HumbaAdob0/3in1bot/README.md

# Hybrid 3-in-1 Bot

## Overview

<p align="center">
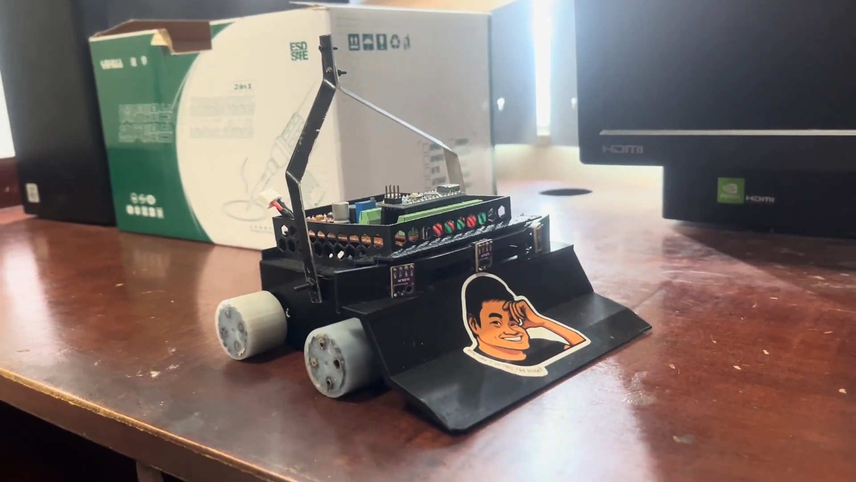
[picture p1: Photos/bot_image.png]
Completed Hybrid 3-in-1 Competition Bot
  
</p>

The Hybrid 3-in-1 Competition Bot is a four-wheel Arduino robotics platform designed for three challenges without rebuilding the electronics: **sumo**, **line following**, and **balloon hunt / pop**. It uses three VL53L0X time-of-flight (ToF) sensors to locate targets, a QTR-8D array to follow lines and detect arena boundaries, and independent left/right motor control for fast turns and recovery.

The competition front is the wedge / sensor side. In balloon mode, the bot uses a fixed front needle to pop a balloon after the center ToF sensor brings it into range.

| Controller | Drive | Modes | Power |
| --- | --- | --- | --- |
| Arduino Nano (ATmega328P) | Left/right differential drive with TB6612FNG drivers | Standby, Sumo, Line Follower, Balloon Hunt | 7.4 V LiPo + regulated 5 V rail |

## Features

- **Sumo mode** — scans with three ToF sensors, steers toward an opponent, and reverses/turns away from the light arena boundary.
- **Line-follower mode** — six active QTR sensors feed an adaptive PD controller with curve slowing, apex braking, and lost-line recovery.
- **Balloon-hunt mode** — locates a balloon with the ToF array, protects the arena boundary, then drives the fixed front needle into the target.
- **Safe mode selection** — a two-switch DIP state machine includes immediate standby and a 5-second default start delay for active modes.
- **Field-tunable firmware** — motor direction, sensor polarity, target distances, speeds, and recovery timing are grouped near the top of [`hybrid_bot.ino`](hybrid_bot.ino).

## CAD model

<p align="center">
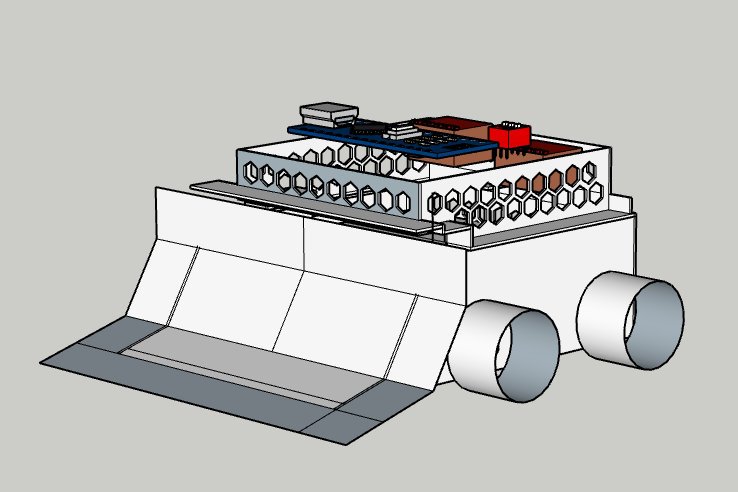
[picture p2: Photos/sketchup_front_view.png]
SketchUp front view of the robot
  
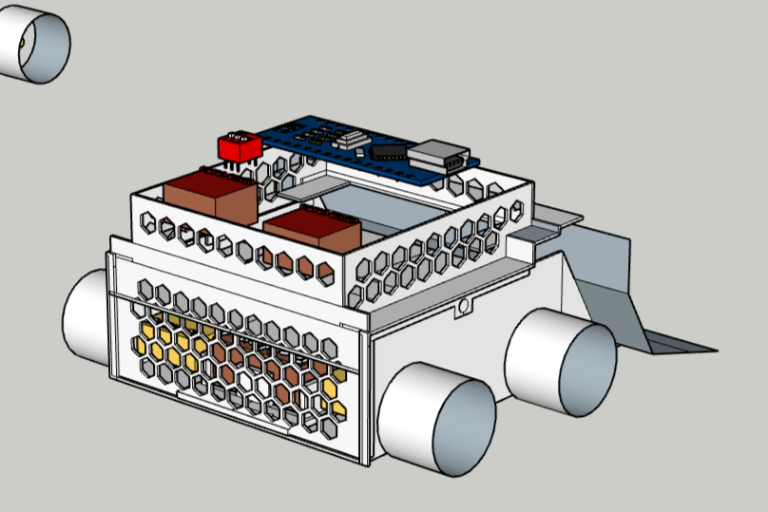
[picture p3: Photos/sketchup_back_view.png]
SketchUp rear view of the robot
  
</p>

The interactive model is available in [SketchUp](https://app.sketchup.com/share/tc/asia/sV_tgGeKpns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). It is a useful starting point for remaking or adapting the chassis, wedge, sensor mounts, and electronics enclosure.

## Build of materials

| Qty. | Part | Role / notes |
| ---: | --- | --- |
| 1 | Arduino Nano (ATmega328P) | Main controller; firmware serial output is 115200 baud. |
| 2 | TB6612FNG dual motor-driver boards | H-bridge motor control. The firmware exposes one PWM/direction group for each side of the drivetrain. |
| 4 | 600 DC gearmotor chassis | Differential drive; the CAD model shows two wheels on each side. |
| 3 | VL53L0X ToF distance sensors | Left, center, and right target detection. The side sensors are mounted about 20° outward. |
| 1 | QTR-8D reflectance / line-sensor array | Line tracking and boundary detection. Six outputs are active in the supplied firmware. |
| 1 | 3-position DIP-switch module | Two positions select the software mode; the third position is available for the power arrangement shown in the schematic. |
| 1 | 7.4 V LiPo battery | Motor supply input. Use a battery appropriate for the motors' current draw. |
| 1 | Step-down (buck) converter | Produces the regulated 5 V logic rail. |
| 1 | Front wedge / plow | Sumo attachment and competition-front reference. |
| 1 | Fixed front needle | Passive balloon popper; install and handle only under appropriate competition safety rules. |
| As needed | Wire, connectors, standoffs, fasteners, chassis material | Use secure, strain-relieved wiring—robot vibration is significant. |

## Wiring and pin map

<p align="center">
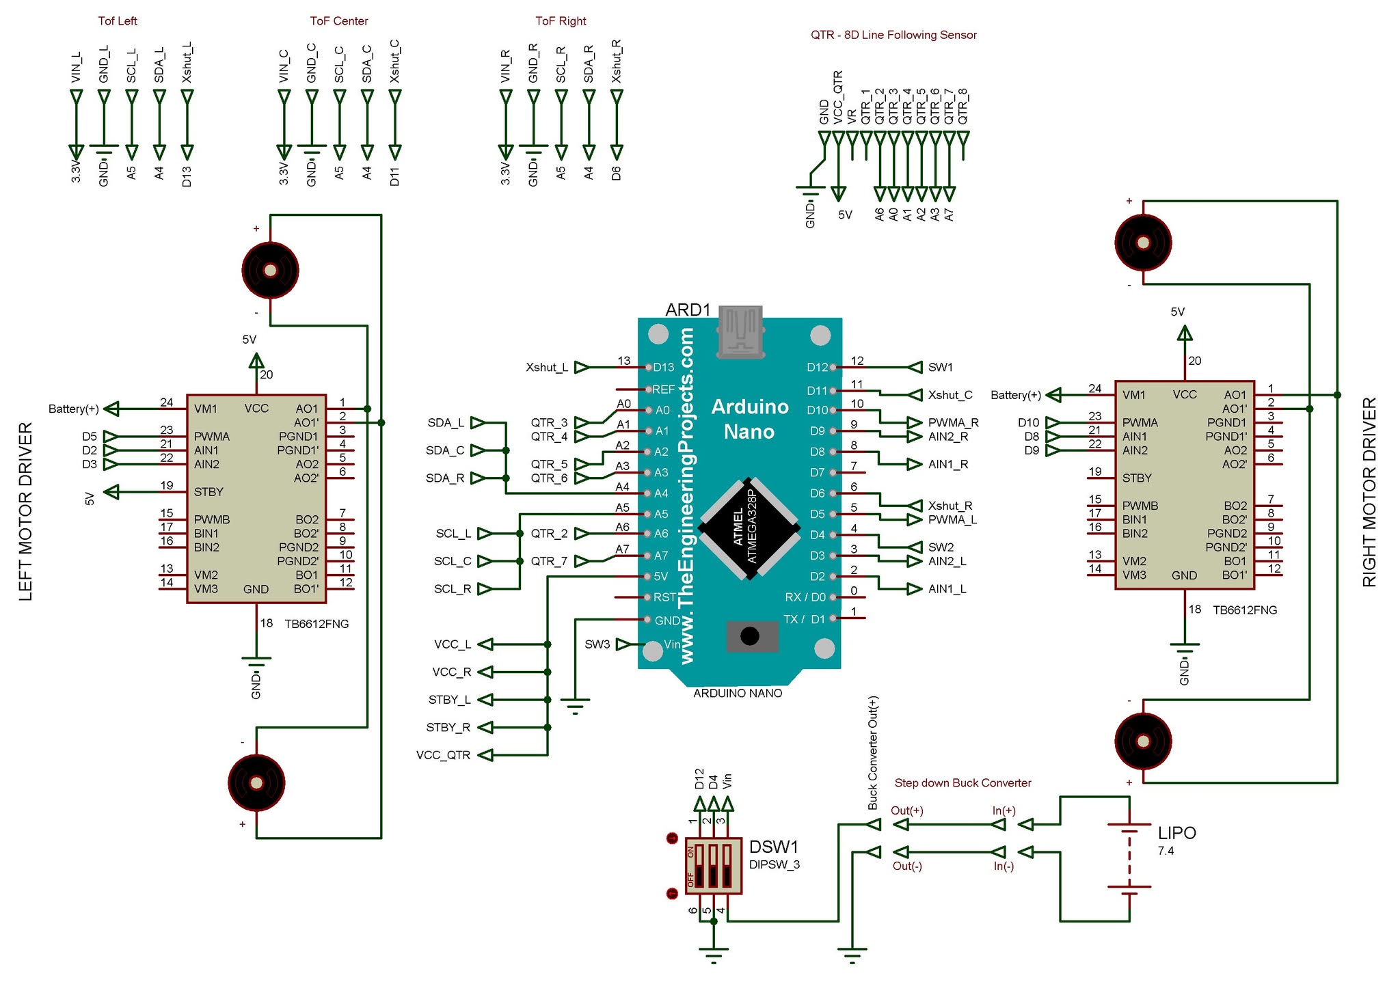
[picture p4: Photos/proteus_pin_map.jpg]
Proteus wiring and Arduino Nano pin map
  <br>
  <sub>Click the diagram to view it at full resolution.</sub>
</p>

The diagram above is the hardware reference. The pin definitions in [`hybrid_bot.ino`](hybrid_bot.ino) are the **source of truth for the current firmware**—especially for the QTR array, where this robot deliberately uses six working channels.

### Power architecture

```text
7.4 V LiPo
  ├──> TB6612FNG VM (motor supply)
  └──> buck converter ──> regulated 5 V logic rail
                              ├──> Arduino Nano 5V
                              ├──> TB6612FNG VCC and STBY
                              └──> QTR-8D VCC

Arduino 3.3 V ──> VL53L0X VIN
All modules ─────> common GND
```

Keep the motor supply, logic supply, and all grounds wired as shown. Do **not** connect the 7.4 V battery directly to a 5 V or 3.3 V sensor rail. Confirm the buck converter output with a multimeter before connecting the Nano or sensors.

### Motor drivers

| Side  | TB6612FNG input | Arduino Nano pin | Purpose |
| ----- | --- | --- | --- |
| Left  | AIN1 | D2 | Direction 1 |
| Left  | AIN2 | D3 | Direction 2 |
| Left  | PWMA | D5 | PWM speed control |
| Right | AIN1 | D8 | Direction 1 |
| Right | AIN2 | D9 | Direction 2 |
| Right | PWMA | D10 | PWM speed control |
| Both  | STBY | 5 V | Keep the drivers enabled |
| Both  | VCC / GND | 5 V / common GND | Logic power |
| Both  | VM | Battery positive | Motor power |

Connect each driver output to its corresponding drivetrain side as shown in the Proteus diagram. If a wheel turns in the wrong direction, change `LEFT_MOTOR_SIGN` or `RIGHT_MOTOR_SIGN` in the firmware before changing the mode logic.

### VL53L0X ToF sensors

All three sensors share the I²C bus. Separate XSHUT lines let the firmware start and re-address them one at a time.

| Sensor | SDA | SCL | XSHUT | I²C address after startup |
| --- | --- | --- | ----- | --- |
| Left | A4  | A5  | D13 | `0x30` |
| Center | A4  | A5  | D11 | `0x31` |
| Right  | A4  | A5  | D6 | `0x32` |

Wire each module's `VIN` to the Nano 3.3 V pin and each `GND` to common ground. The code configures the left and right sensors at roughly 20° outward for a wider detection field.

### QTR-8D line / boundary array

The current sketch uses six channels. `OUT4` is omitted because that physical sensor is defective, and `OUT6` is omitted because the A2 connection read stuck HIGH during testing.

| QTR-8D output, left to right | Arduino Nano pin | Firmware status |
| --- | --- | --- |
| OUT0 | D7 | Used |
| OUT1 | A6 | Used |
| OUT2 | A0 | Used |
| OUT3 | A1 | Used |
| OUT4 | — | Not used — defective sensor |
| OUT5 | A3 | Used |
| OUT6 | — | Not used — A2 reading stuck HIGH |
| OUT7 | A7 | Used |
| VCC / GND | 5 V / common GND | Required |

`A6` and `A7` are analog-input-only Nano pins, so the sketch reads them with `analogRead()` and converts their digital-style signal using the configured threshold. This is intentional.

### DIP-switch mode selector

The firmware uses the Nano's internal pull-ups. An **ON** switch must connect its pin to **GND** (`LOW`).

| SW2 (D4) | SW1 (D12) | Selected mode | What it does |
| --- | --- | --- | --- |
| OFF | OFF | Standby | Stops the motors immediately. |
| OFF | ON | Sumo | Searches for and pushes an opponent while avoiding the ring edge. |
| ON | OFF | Line Follower | Follows a dark line with adaptive PD steering. |
| ON | ON | Balloon Hunt / Pop | Finds a balloon, avoids the boundary, and rams the fixed popper.  |

Changing into an active mode is debounced and then waits 5 seconds by default (`START_DELAY_MS`). Set it to `0` only when that delay is not wanted.

## Getting started

### 1. Build the mechanics

1. Use the [SketchUp model](https://app.sketchup.com/share/tc/asia/sV_tgGeKpns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) and the included renders as a chassis reference.
2. Mount the motors and wedge securely. Place the ToF sensors across the competition front: left, center, then right.
3. Position the QTR array low and square to the floor. Its readings must be stable on both the track and the arena boundary.
4. Fit the fixed needle only when the robot is being used in a controlled balloon-popping event.

### 2. Wire and inspect

1. Follow the pin tables above and [full Proteus diagram](Photos/proteus_pin_map.jpg).
2. Ensure every module shares ground.
3. Verify the 5 V buck output and the 3.3 V ToF supply before attaching electronics.
4. With the wheels raised, test motor directions before putting the robot on a track or sumo ring.

### 3. Upload the firmware

1. Install the Arduino IDE.
2. In Library Manager, install **VL53L0X by Pololu**. `Wire` is included with the Arduino core.
3. Open [`hybrid_bot.ino`](hybrid_bot.ino), select the correct **Arduino Nano** board, processor/bootloader variant, and serial port, then upload.
4. Open Serial Monitor at **115200 baud**. Startup diagnostics report ToF initialization and QTR readings.
5. Leave both DIP switches OFF for standby, then select a mode from the table above.

### 4. Calibrate for your build

No two handmade robots have exactly the same motor direction, floor reflectance, battery voltage, or sensor height. Review the `CONFIG` section before every new arena or track:

| Check | Firmware settings to review |
| --- | --- |
| Drive direction | `LEFT_MOTOR_SIGN`, `RIGHT_MOTOR_SIGN`, `SUMO_FORWARD_SIGN` |
| ToF detection range and response  | `SUMO_*`, `BALLOON_*`, `TOF_ANGLE_DEGREES` |
| QTR polarity / boundary detection | `QTR_DARK_IS_HIGH`, `SUMO_EDGE_IS_DARK`, `BALLOON_BOUNDARY_IS_DARK` |
| Line speed and steering | `LINE_BASE_PWM`, `LINE_MAX_PWM`, `LINE_KP_DIV`, `LINE_KD_DIV` |
| Competition delay and diagnostics | `START_DELAY_MS`, `DEBUG_SERIAL` |

The supplied configuration expects a dark/black sumo platform or line response and a lighter area beyond the boundary. Use the Serial Monitor to confirm actual QTR values before changing polarity flags.

## Firmware behavior

```text
DIP mode
  ├── Standby       → motors stopped
  ├── Sumo          → QTR boundary check → ToF target/chase/search
  ├── Line Follower → QTR weighted position → PD steering/recovery
  └── Balloon Hunt  → QTR boundary check → ToF target/chase → fixed-needle ram
```

In both sumo and balloon modes, boundary escape has priority over target pursuit: the robot reverses, turns inward, and only then resumes the search. The line follower automatically slows for tight curves and pivots toward the last known line direction if the line disappears.

By default, balloon popping is passive (`USE_ELECTRIC_POPPER 0`). The code has a provision for an optional electronic popper, but no actuator should be connected directly to an Arduino pin; use a suitable MOSFET, servo driver, or other driver stage.

## Repository layout

| Path | Description |
| --- | --- |
| [`hybrid_bot.ino`](hybrid_bot.ino) | Arduino firmware for all four operating modes. |
| [`Photos/bot_image.png`](Photos/bot_image.png) | Photograph of the completed robot. |
| [`Photos/sketchup_front_view.png`](Photos/sketchup_front_view.png) | Front CAD render. |
| [`Photos/sketchup_back_view.png`](Photos/sketchup_back_view.png) | Rear CAD render. |
| [`Photos/proteus_pin_map.jpg`](Photos/proteus_pin_map.jpg) | Wiring and Arduino Nano pin-map reference. |
| [`LineFollower-Track-ModelV2.pdf`](LineFollower-Track-ModelV2.pdf) | Line-follower course reference. |

## Contributing and open source

This project is intended to be a practical, remixable starting point for student and competition robotics. Contributions are especially useful when they improve reproducibility:

- Document tested substitutions for motors, drivers, batteries, sensors, or chassis materials.
- Include measured sensor height, arena/track color, battery voltage, and tuning values with any control changes.
- Keep wiring changes synchronized with both the pin-map image and the `PIN MAP` section of the firmware.
- Test changes with wheels raised first, then in a controlled arena, before opening a pull request.

There is currently no license file in this repository. Add an explicit open-source license (for example, MIT) before publishing or reusing the project under open-source terms.

## Safety

- Remove or elevate the wheels while uploading, wiring, and testing motor code.
- Use a correctly rated LiPo charger, inspect battery condition, and disconnect power before modifying wiring.
- Keep hands clear of the wedge, wheels, and balloon-popping needle. Use the needle only where event rules allow it.
- Never power sensors from an unverified buck converter output, and never run motor current through the Nano's 5 V pin.

---

Built for learning, competition, and iteration. If you remake it, share your changes so the next robot builder can start one step ahead.
