HumbaAdob0/3in1bot/LineFollower-Track-ModelV2.pdf

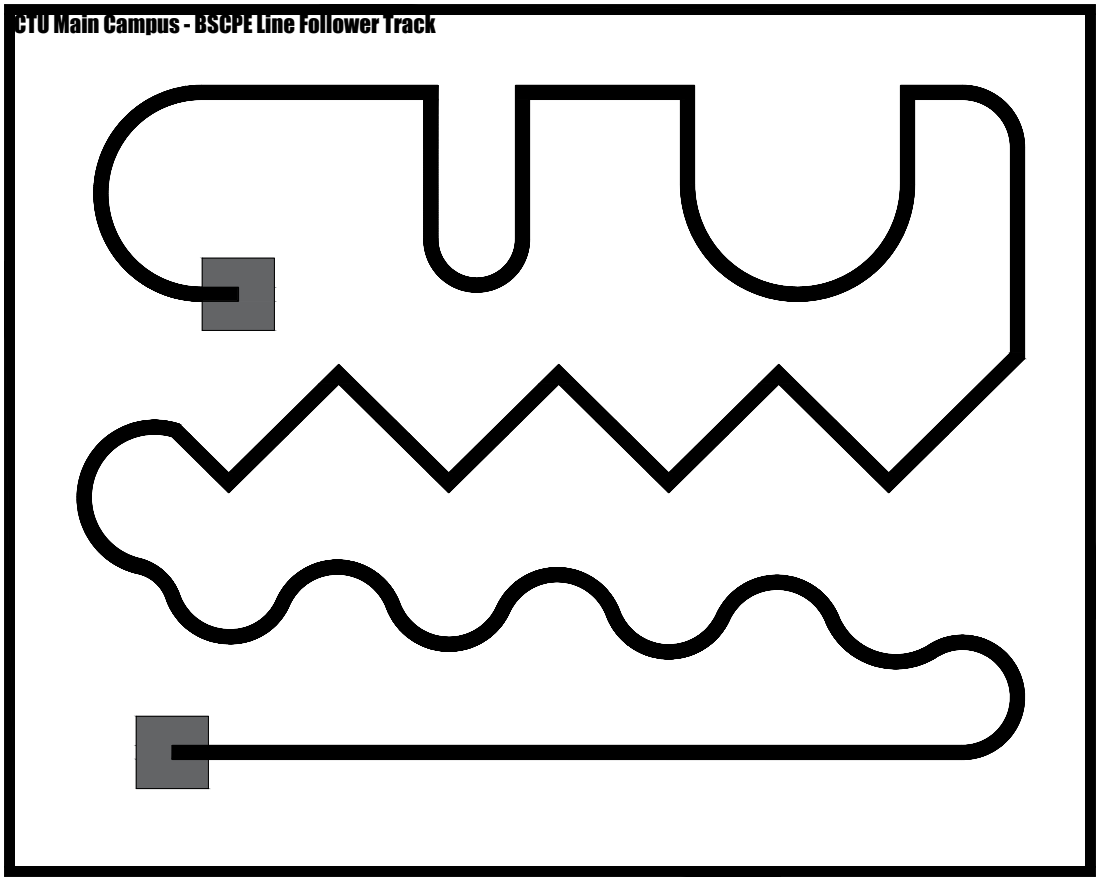
[picture p5: page 1]

CTU Main Campus - BSCPE Line Follower Track
